banana99ou/Stewart-Platform/doc/chat_log_2026-02-09.md

# Chat log (2026-02-09) — Stewart Platform Physical HILS paper + analysis

This document summarizes the key outcomes of an assistant session focused on writing the KSAS paper, validating claims against code/logs, and updating the analysis/figure pipeline.

## Scope of the session

- Drafted example text for **Introduction / Main body / Conclusion** sections.
- Fact-checked `paper/Paper_draft.md` against:
  - implementation (`hils_host.py`, `postprocess_run.py`)
  - measured results (`logs/run-.../postprocess_metrics.json`, runs #5–#9)
- Clarified the correct interpretation of **workspace / saturation** (baseline runs are inside workspace → saturation is 0%).
- Addressed the “residual error is mainly FC mounting bias” narrative by:
  - distinguishing “simulation-vs-physical tracking” from “mounting bias”
  - implementing mounting-bias estimation using **platform pose** (commanded pose in logs) as reference
- Implemented a “one-click” figure generator and verified it runs in a venv.

## Dataset conventions agreed

- **Baseline (post-fix)**: runs **#5–#9** (firm mounting, speed PID enabled).
- **Hero run for time-series figures**: run **#8**.
  - Rationale: best-looking overlay and lowest pitch error RMS among runs #5–#9 (also recorded in `ToDo.md`).
- **Pre-fix illustrative run**: run **#4** (loose mounting; not comparable to baseline for aggregate stats).
- **Analysis window**: default skip first **10 s** to avoid startup transients.

## Key findings extracted from logs (runs #5–#9)

- **Saturation**:
  - `pct_saturated_count = 0.0%`
  - `pct_saturated_time = 0.0%`
  - Interpretation: baseline runs remain within feasible workspace; clamping/saturation is not active during the reported dataset.
- **Latency (paper-quotable ranges across runs #5–#9)**:
  - Stewart serial RTT mean ≈ 21.6–21.9 ms; P95 ≈ 33.6–33.9 ms; max up to ~80 ms (run dependent).
  - End-to-end proxy (PX4 rx → ACK rx) mean ≈ 20.4–20.7 ms; P95 ≈ 32.9–33.2 ms.
  - End-to-end proxy (X-Plane rx → ACK rx) mean ≈ 26.4–31.3 ms; P95 ≈ 48.9–62.8 ms.

## Methodology correction: mounting bias reference

An important correction was made:

- **Mounting bias** must be estimated from **PX4 attitude vs platform pose** (top plate frame).
- Using **X‑Plane attitude** as the mounting-bias reference was rejected as conceptually invalid.
- The chosen reference available in logs is the **commanded platform pose** in `tick.csv`:
  - `cmd_roll_deg`, `cmd_pitch_deg`, `cmd_yaw_deg`

## Code changes introduced

### 1) `postprocess_run.py`

Added mounting-bias estimation and bias-corrected tracking metrics:

- Reads `scenario_phase` from `tick.csv`.
- Estimates mounting bias in a steady window:
  - Prefer `scenario_phase == "hold_0"` and `pid_enabled == 1` (when present), within the analysis window.
  - Computes (roll/pitch):
    - `bias = mean(wrap(px4 - cmd))`
- Emits:
  - `mounting_bias_deg` in the output metrics JSON.
  - Additional error series in `tracking_error_deg`:
    - `roll_px4_biascorr_minus_xp_deg`, `pitch_px4_biascorr_minus_xp_deg`
    - `roll_px4_biascorr_minus_cmd_deg`, `pitch_px4_biascorr_minus_cmd_deg`
- Pitch response plot updated to include:
  - `X-Plane pitch + mounting bias` (shifted by the estimated bias) for visual alignment.

### 2) `paper/Paper_draft.md`

Updated Section 6–7 and Conclusion to match the new method:

- Explicitly states mounting bias is estimated from **PX4 − commanded platform pose** during `hold_0`.
- States that **pre/post bias-correction** tracking errors are presented.

### 3) `paper/Fig_Gen.py`

Added a new “one-click” figure generator that uses real logs (not synthetic data):

- Loads:
  - baseline runs #5–#9
  - hero run #8
  - pre-fix run #4 (for before/after illustration)
- Applies analysis window (skip first 10 s).
- Estimates pitch mounting bias from `wrap(px4_pitch - cmd_pitch)` in `hold_0`.
- Writes figures to `paper/fig/`:
  - `Fig2_PitchResponse_Hero.png`
  - `Fig3_PitchError_Hero.png` (raw vs bias-corrected)
  - `Fig4_MountingBias_TimeSeries.png` (pre vs post)
  - `Fig5a_Latency_TimeSeries_Hero.png`
  - `Fig5b_Latency_Distribution_Baseline.png`
  - `FigGen_manifest.json`

## Figure strategy agreed (for Section 7: Results & Discussion)

- **Fig2 (hero run)**: pitch response overlay (readability).
- **Fig3 (hero run)**: tracking error time series, raw vs bias-corrected.
- **Fig4**: “mounting bias proof”
  - preference: Option B time series (shows initial chaos → stable offset), with an optional aggregate inset/table.
- **Fig5**: latency/timing evidence
  - include both hero run time series and aggregate distributions across baseline runs (#5–#9).
- Use run #1–#4 only as “pre-fix” illustration, not in baseline aggregates.

## Environment notes

- A Python virtual environment was created at `.venv/` and `pip install -r requirements.txt` was used to install:
  - numpy, matplotlib, pyserial, pymavlink
- `paper/Fig_Gen.py` was executed successfully in the venv and generated the listed PNG outputs under `paper/fig/`.
