banana99ou/Stewart-Platform/presentation/Conference_presentation_script.md

# Conference Presentation Script

Korean spoken script first (for reading aloud), English reference below (for LLM context).
Slide numbers match the current deck (17 slides).

---

# 발표 대본 (Korean Spoken Script)

## 슬라이드 1 — 제목

안녕하세요, 국민대학교 미래모빌리티제어연구실 석사과정 정현용입니다.

오늘은 비행 시뮬레이션에 맞춰 실제 비행 하드웨어가 반응하는 걸 눈으로 확인할 수 있는 시스템을 소개하겠습니다. 플랫폼이 기울면 조종면이 실제로 움직이도록, 스튜어트 플랫폼 위에 실물 UAV를 탑재하고, X-Plane 시뮬레이터와 하나의 루프로 연결했습니다. 

시스템 구조, baseline 실험 결과, 그리고 정량적으로 확인한 가능성과 한계를 보여드리겠습니다.

`>> NEXT SLIDE`

## 슬라이드 2 — 왜 물리적 운동을 HILS에 추가하는가?

그러면 왜 HILS에 실제 움직임을 추가해야 할까요?

핵심은 가상 입력을 넣는 데서 끝내지 않는다는 점입니다. 비행 제어기와 IMU가 실제 운동을 경험하고, 그 결과가 조종면 반응으로 이어지는지를 직접 확인하고자 했습니다.

저희는 이를 고정익으로 먼저 실증했고, 원리적으로는 다른 기체에도 적용 가능합니다.

오늘은 이 시스템이 안정적으로 동작하고, 추종 성능을 정량화할 수 있다는 것을 실험 데이터로 보여드리겠습니다.

`>> NEXT SLIDE`

## 슬라이드 3 — 무엇이 새로운가?

그러면 구체적으로 뭐가 새로운 걸까요?

첫째, 비행 하드웨어가 시뮬레이션 시나리오에 맞춰 실제로 반응하는지를 눈으로 확인할 수 있습니다. 기존 HILS에서는 로그나 화면으로만 확인하던 것을, 여기서는 물리적으로 직접 볼 수 있습니다.

둘째, PX4의 추정기가 합성 신호가 아니라 실제 관성 운동에 반응합니다. 소프트웨어로 주입된 데이터가 아니라 진짜 움직임을 추정기가 경험하는 겁니다.

스튜어트 플랫폼이 이 두 가지를 가능하게 하는 물리적 연결 고리입니다. 실제 데이터로 보여드리겠습니다. 먼저 시스템이 작동하는 모습부터 보겠습니다.

`>> NEXT SLIDE`

## 슬라이드 4 — 시스템 구동 모습

[데모 영상 재생]

지금 보시는 것은 baseline 실험인 트림 전환 시나리오입니다. X-Plane이 피치 0도에서 +5도로 전환하면, 스튜어트 플랫폼이 그에 맞춰 기울어집니다. 조종면이 실제로 움직이는 게 보이실 겁니다 — 비행 제어기가 시뮬레이션에 맞춰 물리적으로 반응하고 있는 것입니다.

다음으로 시스템 구조를 살펴보겠습니다.

`>> NEXT SLIDE`

## 슬라이드 5 — 물리적 폐루프 동작 원리

이제 폐루프가 실제로 어떻게 동작하는지 보겠습니다.

[그림 1: 시스템 구조/데이터 흐름도 — 번호 1~4 표시]

그림에 표시된 대로, X-Plane 상태가 호스트를 거쳐 플랫폼 명령이 되고, PX4가 그 움직임을 감지해서 다시 호스트로 돌아옵니다. 호스트의 PID가 조종면 명령을 X-Plane에 주입하면 루프가 닫힙니다. 각 블록을 자세히 보겠습니다.

`>> NEXT SLIDE`

## 슬라이드 6 — 블록 1: X-Plane 시뮬레이터

[구조도에서 1번 블록 강조]

X-Plane이 동역학을 연산하고, UDP로 기체 상태를 호스트에 전송합니다. 기존에는 이 안에서 루프가 닫혔지만, 이 구조에서는 PX4 자세가 물리적 경로를 거쳐 되돌아옵니다. 즉 시뮬레이터는 동역학 연산에 집중하고, 센서 반응은 실제 하드웨어가 담당하는 구조입니다.

`>> NEXT SLIDE`

## 슬라이드 7 — 블록 2: Python 호스트

[구조도에서 2번 블록 강조]

호스트는 통합 허브입니다. X-Plane 상태와 PX4 추정값을 동시에 수신하고, 플랫폼 명령 변환, 공통 타임스탬프 로깅, PID 제어 출력까지 모두 여기서 처리합니다. 각 스트림이 서로 다른 주기로 들어오기 때문에, 여기서의 타이밍 처리가 전체 루프 지연에 직접 영향을 줍니다.

`>> NEXT SLIDE`

## 슬라이드 8 — 블록 3: Stewart 플랫폼 구동

[구조도에서 3번 블록 강조]

스튜어트 플랫폼은 호스트의 pose 명령을 받아 실제 물리적 모션으로 변환합니다. 시리얼 명령-ACK 왕복 시간은 약 22 ms입니다. 이 블록 이후부터 PX4가 경험하는 것은 실제 관성 운동입니다. 이 물리적 변환이 기존 소프트웨어 HILS와 구분되는 핵심 지점입니다.

`>> NEXT SLIDE`

## 슬라이드 9 — 블록 4: PX4 센싱 및 귀환

[구조도에서 4번 블록 강조]

PX4의 IMU가 플랫폼의 실제 운동을 감지하고, 추정기가 자세를 산출합니다. 이 추정값이 호스트로 돌아와 PID 제어기를 거쳐 X-Plane에 주입되면 루프가 완성됩니다. 중요한 건, PX4 펌웨어를 별도로 수정하지 않았다는 점입니다. PX4 입장에서는 그냥 실제 운동을 감지하고 반응할 뿐입니다.

`>> NEXT SLIDE`

## 슬라이드 10 — 실험 설계 및 측정 방법

자, 그러면 실제로 무엇을 실험했는지 보겠습니다.

기본 시나리오는 trim transition입니다. 피치를 0도에서 +5도로 올렸다가, 유지한 뒤, 다시 돌아옵니다. 모든 실험은 동일한 X-Plane 초기 조건인 호놀룰루 PHNL 10해리 어프로치에서 시작합니다.

각 실험은 포화 플래그를 감시하면서 9회 반복하여 통계적 유의미성을 확보했습니다. 시스템 자체의 지연, 바이어스, 장착 효과를 먼저 분리해야 하므로, 이처럼 제어된 조건의 깨끗한 baseline 시나리오에서 출발합니다.

`>> NEXT SLIDE`

## 슬라이드 11 — 결과 1: 폐루프 추종 달성

이제 결과를 보겠습니다.

[그림 2: 피치 응답 오버레이]

주황색 선이 PX4 피치, 파란 점선이 X-Plane 명령 피치입니다. 전체적으로 안정적으로 추종하고 있는데, 약 1.8도 정도 일정하게 벌어져 있는 걸 볼 수 있습니다. 이건 장착 바이어스로 추정됩니다. 이 바이어스만큼 보정한 것이 파란 실선인데, 보정 후에는 추종이 훨씬 가까워집니다.

핵심은, 폐루프 추종이 작동하고, 지배적 오차가 물리적으로 설명된다는 점입니다.

`>> NEXT SLIDE`

## 슬라이드 12 — 결과 2: 장착 품질이 주된 오차의 원인

바이어스가 있다면, 어디서 오는 걸까요? 장착 품질이 원인이라는 가설을 두 가지 근거로 확인했습니다.

[그림 3: 피치 오차 + 그림 4: 장착 바이어스 근거]

첫 번째 근거. 장착 조건을 바꾸면 바이어스의 거동이 달라집니다. 느슨한 장착 — 접착 테이프만 사용한 조건에서는 관성 하중에 의해 FC가 서서히 밀리면서 바이어스가 시간에 따라 증가합니다. 단단한 장착 — 접착제에 기계적 결속을 추가한 조건으로 바꾸면 이 드리프트가 사라집니다.

두 번째 근거. 단단한 장착 조건에서 남는 바이어스는 실험 내내 거의 일정합니다. 이는 남은 오차가 동적 불안정이 아니라, 장착 시 생긴 고정된 정렬 오차라는 뜻입니다.

두 근거를 종합하면, 주된 피치 오차의 원인은 제어 시스템이 아니라 장착 품질입니다. 장착을 잡으면 오차가 보정 가능한 정적 바이어스로 수렴하며, 후처리 스크립트가 이 바이어스를 자동으로 추정하고 보정합니다.

`>> NEXT SLIDE`

## 슬라이드 13 — 결과 3: 지연 특성화 및 시스템 성능

추종이 되는 것은 확인했는데, 그러면 이 시스템이 얼마나 빠르게 반응할 수 있을까요?

[그림 5(a): 지연 시계열 + 그림 5(b): 지연 분포]

지연을 네 구간으로 분해했습니다. X-Plane 샘플 에이지는 시뮬레이터 데이터가 호스트에서 사용될 때까지의 경과 시간, PX4 샘플 에이지는 PX4 자세 추정값이 호스트에 도달할 때까지의 경과 시간, 시리얼 RTT는 호스트에서 플랫폼으로 명령을 보내고 ACK를 받기까지의 왕복 시간, 종단간 지연은 X-Plane 데이터 수신부터 플랫폼 구동 완료까지의 총 시간입니다.

왼쪽 시계열에서 각각 파란색, 주황색, 초록색, 빨간색으로 표시했고, 실선이 구간 평균, 음영이 최소-최대 범위입니다. 빨간 종단간 선이 약 40에서 60 ms 대에서 움직입니다.

오른쪽 박스 플롯은 baseline 5회 전체의 분포입니다. 종단간 중앙값이 약 48 ms이고, X-Plane 에이지 약 27 ms, PX4 에이지 약 19 ms, 시리얼 RTT 약 22 ms가 겹쳐 누적됩니다.

실용적으로 보면, 이 정도 지연은 오늘 보신 트림 전환처럼 천천히 변하는 기동에는 충분하지만, 급격한 교란을 재현하려면 제약이 될 수 있습니다.

이렇게 누적된 지연이 시스템이 얼마나 빠른 움직임까지 재현할 수 있는지를 결정합니다. 분포에서 보시듯 지터 폭이 상당하기 때문에, 현재 데이터만으로 유효 bandwidth를 확정하기는 어렵습니다. 이 부분은 향후 sine-sweep 측정으로 정량화할 계획입니다.

`>> NEXT SLIDE`

## 슬라이드 14 — 핵심 정리

정리하겠습니다.

첫째, 시뮬레이션 시나리오에 맞춰 실제 비행 하드웨어가 물리적으로 반응하는 것을 확인할 수 있는 시험 환경을 구현했습니다. X-Plane, 스튜어트 플랫폼, PX4가 하나의 물리적 폐루프로 동작합니다.

둘째, 이 시스템의 추종 성능을 정량적으로 확인했습니다. 바이어스 보정 후 피치 추종 오차 RMSE 약 0.46도, 종단간 지연 약 48 ms입니다.

셋째, 시스템 특성화를 통해 향후 확장의 기반을 확보했습니다. 지연, 바이어스, 작업 영역의 한계를 정량적으로 파악함으로써, 교란 실험이나 다른 기체로의 확장을 위한 baseline을 마련했습니다.

다만 이 시스템이 기존 소프트웨어 HILS나 실제 비행 시험을 대체하는 것은 아닙니다. 플랫폼의 작동 영역은 유한하고, 공기역학적 하중은 재현하지 못하며, 유효 bandwidth도 아직 측정이 필요합니다. 이 시스템의 위치는 소프트웨어 HILS와 비행 시험 사이의 보완적 검증 수단입니다.

향후 계획으로는, 단기적으로 시간 정렬 오차 분석, sine-sweep 기반 bandwidth 측정, 반복성 특성화, 포화 경계 부근 스트레스 시험을 예정하고 있습니다. 장기적으로는 멀티로터 등 다른 기체로 확장하여 아키텍처의 범용성을 실증하는 것이 목표입니다.

`>> NEXT SLIDE`

## 슬라이드 15 — 마무리

감사합니다.

`>> BACKUP SLIDE (if needed)`

## Q&A 답변

가능성 높은 순서로 정렬했습니다. 각 답변에 프레젠테이션 이동 지시를 포함했습니다.

**1. "공기역학적 하중을 재현하지 못하는데, 그러면 실제 비행과 얼마나 비슷한가?"**
[프레젠테이션: 슬라이드 14로 이동 — 한계와 위치 설명]
실제 비행과 완전히 같다고 말할 수는 없습니다. 다만 비행 시나리오와 기체 동역학은 X-Plane이 제공하고, 그 결과에 맞춰 실제 하드웨어가 물리적으로 움직이면서 PX4의 IMU와 추정기가 합성 신호가 아니라 실제 운동을 경험합니다. 따라서 순수 software HILS보다는 실제 비행에 가깝지만, flight test를 대체하지는 않는 보완적 수단이라고 설명하는 것이 정확합니다.

**2. "왜 기존 software HILS가 아니라 이 시스템이 필요한가? 시험평가 관점에서 어떤 추가 가치가 있나?"**
[프레젠테이션: 슬라이드 3으로 이동 — 핵심 차별점 슬라이드]
핵심은 센서 신호를 소프트웨어로 합성해 넣는 데서 끝나지 않는다는 점입니다. 이 시스템에서는 비행 제어기와 IMU가 실제 물리 운동을 경험하고, 그 결과가 다시 폐루프에 반영됩니다. 즉 software HILS보다 물리성이 높고, 제어기와 추정기가 실제 운동에 어떻게 반응하는지를 직접 관찰할 수 있다는 점에서 시험평가 단계의 추가 정보를 제공합니다.

**3. "지연은 어떻게 측정했고, 이 지연으로 볼 때 어느 정도 기동까지 평가 가능한가?"**
[프레젠테이션: 슬라이드 13으로 이동 — 지연 데이터 보여주며 답변]
호스트 기준의 공통 타임스탬프로 각 스트림의 수신 시각과 Stewart ACK 시각을 기록하고, 이를 tick 시각 축에 인과적으로 다시 맞춰 X-Plane sample age, PX4 sample age, serial RTT, end-to-end delay를 계산했습니다. 현재 근거로 제시할 수 있는 것은 종단간 지연 약 48 ms와 그 분포이며, 지터 폭이 있기 때문에 현재 데이터만으로 유효 attitude bandwidth를 확정하는 것은 과도한 주장입니다. 그래서 지금 단계에서는 trim transition 같은 저주파 기동에 적합하다고 설명하고, 정량적 bandwidth는 전용 sine-sweep 측정으로 제시할 계획입니다.

**4. "실험 간 반복성은 어떤가? 다시 장착하거나 다시 실행해도 같은 결과가 나오나?"**
[프레젠테이션: 슬라이드 12로 이동 — Fig 4 보여주며 답변]
firmly fixed baseline 5회 기준으로 보면, 실험 내 바이어스 표준편차는 약 0.2°이고 실험 간에는 최대 0.8° 정도 차이가 나타났습니다. 이는 열적 드리프트와 미세한 재장착 차이 때문으로 보고 있습니다. 즉 완전히 무시 가능한 수준이라고 하기는 어렵지만, 반복 실험을 통해 변동 폭을 확인했고 체계적인 반복성 특성화는 향후 과제로 남아 있습니다.

**5. "아까는 9회 반복이라고 했는데, 뒤에서는 baseline 5회라고 했다. 정확히 어떤 데이터셋으로 평가한 건가?"**
[프레젠테이션: 슬라이드 10으로 이동 — 실험 집합 설명]
총 9회가 맞습니다. 이 중 4회는 loose mounting 조건이고, 5회는 firmly fixed mounting 조건입니다. 발표 후반의 baseline 분포와 정량 평가는 firmly fixed된 5회 run을 중심으로 해석했고, loose mounting 4회는 장착 품질이 바이어스 거동에 어떤 영향을 주는지 비교하기 위한 근거로 사용했습니다.

**6. "플랫폼이 개루프인데 포즈 정확도를 얼마나 신뢰할 수 있나?"**
[프레젠테이션: 슬라이드 15 유지 — 구두 답변]
저비용 구현을 위해 인코더 피드백이 없는 RC 서보를 사용했기 때문에 플랫폼 자체는 개루프 구동입니다. 그럼에도 디지털 경사계로 정적 자세 정확도를 측정한 결과, 롤 약 0.1도, 피치 약 0.5도 수준의 오차 상한을 확인했습니다. 즉 플랫폼 포즈를 연속적으로 직접 피드백하지는 않지만, 플랫폼 수준 오차가 어느 정도인지는 별도로 확인했고, 루프 안에서는 PX4 IMU가 유일한 물리 측정 수단으로 동작합니다.

**7. "장착 바이어스가 주된 오차라면, 이 결과는 시스템 성능보다 장착 품질을 본 것 아닌가?"**
[프레젠테이션: 슬라이드 12로 이동 — Fig 3/4 보여주며 답변]
오히려 이번 결과의 중요한 결론이 바로 그 점입니다. 주된 피치 오차가 제어기 불안정이나 루프 붕괴가 아니라, 장착 품질에서 비롯된 물리적 정렬 오차로 설명된다는 것을 확인했습니다. 즉 폐루프 자체는 동작하고 있고, 지배적 오차원이 무엇인지 분리해냈다는 점이 의미입니다. 장착이 안정화되면 오차는 보정 가능한 정적 바이어스로 수렴합니다.

**8. "왜 pitch trim transition만 먼저 검증했나? 시험 시나리오가 너무 단순한 것 아닌가?"**
[프레젠테이션: 슬라이드 10으로 이동 — 실험 설계, 필요하면 슬라이드 14로 이동]
첫 단계에서는 시스템 자체의 지연, 바이어스, 장착 효과를 먼저 분리해서 보기 위해 가장 해석이 깔끔한 baseline 시나리오를 선택했습니다. 그래서 pitch 중심 trim transition으로 시작했습니다. 단순 시나리오를 먼저 택한 이유는 시스템 특성화를 명확하게 하기 위해서이며, 다축 기동과 스트레스 시험은 다음 단계 과제로 두었습니다.

**9. "포화는 어떻게 관리했고, 결과가 포화 영향 없이 나온 것이라고 볼 수 있나?"**
[프레젠테이션: 슬라이드 10으로 이동 — 실험 설정 슬라이드]
baseline 명령이 z=+20 mm에서의 가용 회전 범위 안에 들어오는지 먼저 확인하고, Stewart saturation flag를 계속 모니터링했습니다. baseline 지표에서는 run에 따라 포화 비율이 0-1% 수준이어서, 현재 발표의 baseline 결과는 대체로 정상 영역 거동으로 해석하고 있습니다. 포화 경계 부근의 동작은 별도의 stress test로 다루는 것이 더 적절합니다.

**10. "이 시스템은 결국 무엇을 검증하는 도구인가? 비행제어기 성능인가, 센서 반응인가, 아니면 통합 시험환경 자체인가?"**
[프레젠테이션: 슬라이드 14로 이동 — 핵심 정리 슬라이드]
현재 단계에서는 통합된 물리적 폐루프 시험 환경을 구현하고, 그 기본 특성을 정량화했다고 표현하는 것이 가장 정확합니다. 즉 완성된 비행제어 성능 검증 체계를 최종 확립했다기보다, 비행 하드웨어 반응, 추종 성능, 지연, 바이어스, 작업 영역의 한계를 함께 평가할 수 있는 baseline 시험 플랫폼을 제시한 것입니다.

---

## 발표 운용 참고사항

- 기술적 심화는 슬라이드 11(추종), 12(바이어스), 13(지연)에 집중.
- 슬라이드 4 (데모 영상)에서 트림 전환 시나리오를 구두로 연결 — 15~20초 이내, "이 동작의 데이터를 결과에서 보겠습니다"로 전환.

---
