banana99ou/Stewart-Platform/doc/Prof_feedback_2026-03-20_presentation.md

# Professor Feedback — KSAS Presentation Draft (2026-03-20)

Context: 1차 초안 (압축_발표_대본.pdf + KSAS_Spring2026_Presentation.pdf) 기반 피드백

---

## Original questions asked

1. 연구 framing: broader physical HILS vs IMU-in-the-loop estimator validation 중심
2. Stewart platform 설명 범위: working area/z 선정/saturator 등 어디까지 포함할지

## Feedback

1. 둘 다 좋아 보이는데 정현용학생이 학회에서 참가자분들과 논의하기 편리한 것으로 하시면 됩니다.
2. 학회 발표시에는 세부적인 디테일은 그냥 표 정도로 넣고 참고용으로 제시만 하시고 시시콜콜 설명하지 않는 편이 낫겠습니다. 프로젝트의 스토리텔링에 집중해서 청중들이 흥미로워할 수 있는 부분을 강조해 주세요.
3. 초안에서 사진이 아직 없어서 아쉬운데 작동 동영상도 있으면 좋겠습니다. 단순히 작동하는거 봤지? 가 아니라 특정 시나리오에 대한 작동 영상을 보여주면서 움직님을 설명할 수 있는 것으로요.
4. 폰트가 너무 얇아서 잘 안보일것같습니다. 발표 환경에 강건하게 잘 보이는 폰트로 하시고 큼직큼직하게 해주세요. 굳이 안 읽어도 전체 흐름 이해에 문제없는 내용만 작은 글씨로 하세요.
5. 5페이지 블록 요소별로 대표 사진 + 다른 요소와 주고받는 정보에 대한 상세설명 슬라이드를 만들어 주세요. 깔끔하게 하시긴 했는데, 처음 보는 입장에서 한 슬라이드에 들어가는 정보가 너무 많으므로 분산시키면 좋겠습니다.
6. 각 그래프들 배치는 널찍널찍하게 잘 하셨습니다만, 실선 굵기를 좀 더 굵게 해서 잘 보이게 하시고 겹치는 부분이 많은 그래프는 마커나 점선 등으로 확실히 구분되게 해주세요.
7. 표지에 국문 제목도 적어주세요.
