banana99ou/Stewart-Platform/paper/fig/Decision Options A B Flow-2026-02-05-113706.png

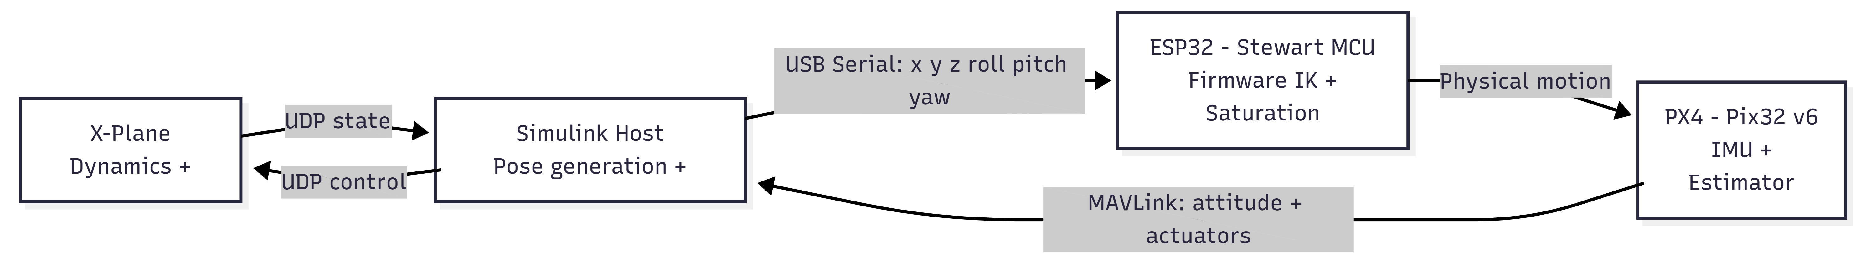
paper/fig/Decision Options A B Flow-2026-02-05-113706.png
