banana99ou/Stewart-Platform/paper/fig/Fig2_TrimTransition.png

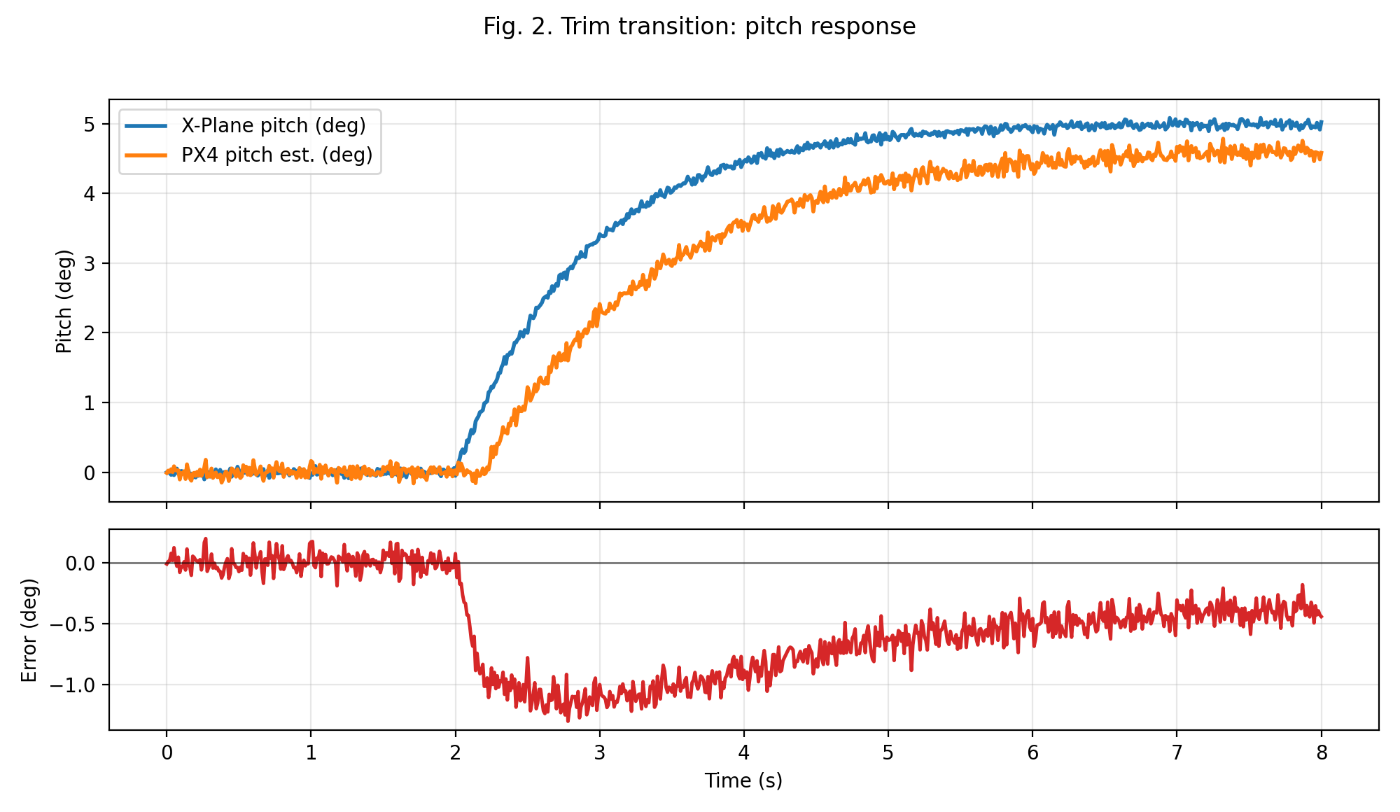
paper/fig/Fig2_TrimTransition.png
