banana99ou/Stewart-Platform/paper/fig/Fig3_LatencyBreakdown.png

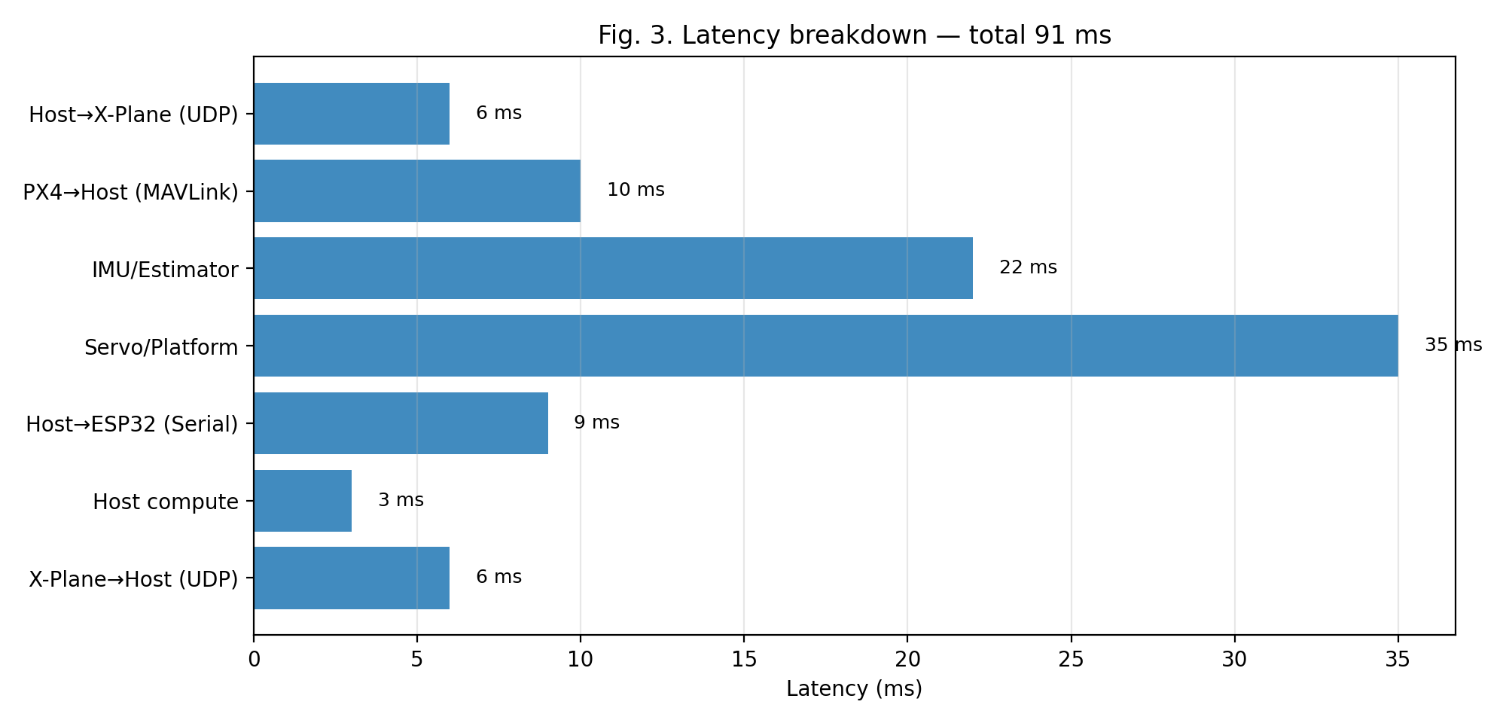
paper/fig/Fig3_LatencyBreakdown.png
