banana99ou/Stewart-Platform/presentation/fig/Fig5a_Latency_TimeSeries.png

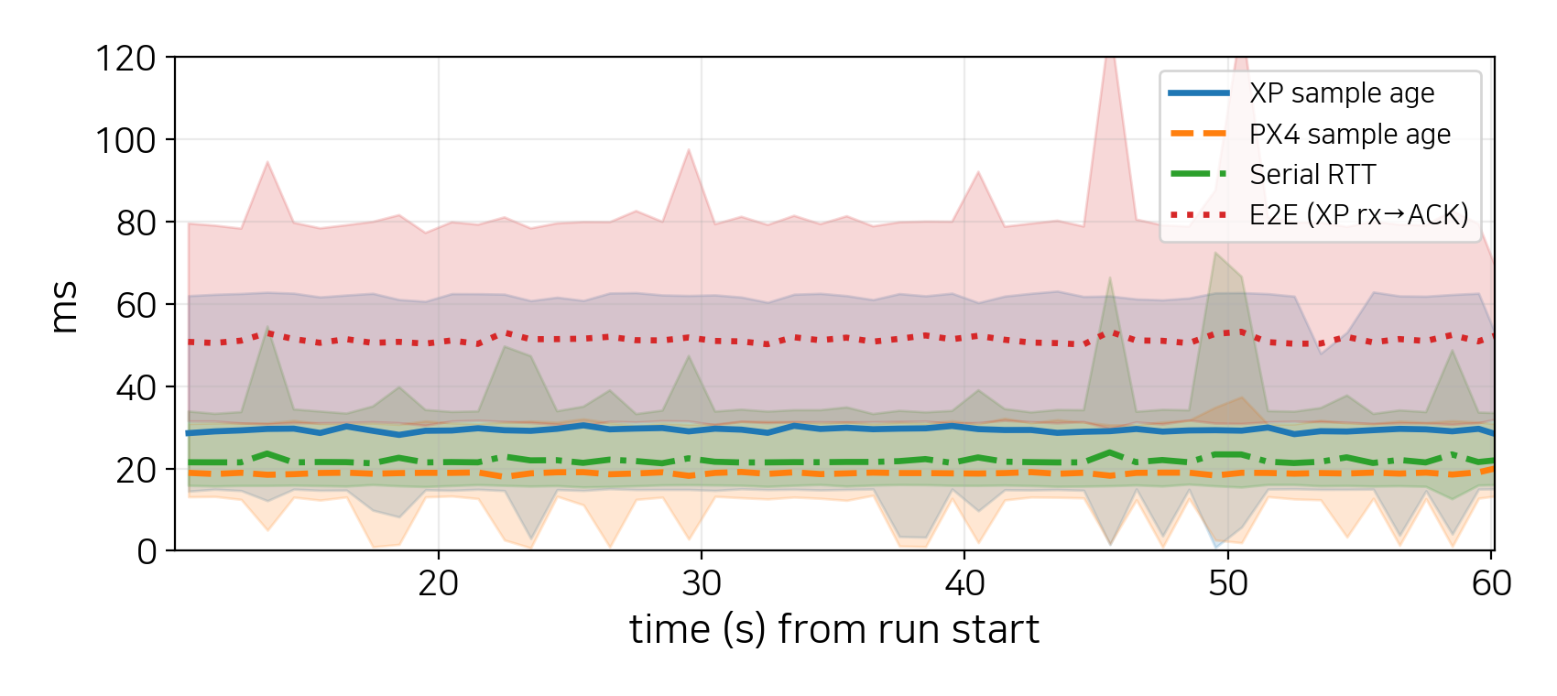
presentation/fig/Fig5a_Latency_TimeSeries.png
