banana99ou/Stewart-Platform/presentation/fig/KakaoTalk_Photo_2026-03-24-22-50-34 004.jpeg

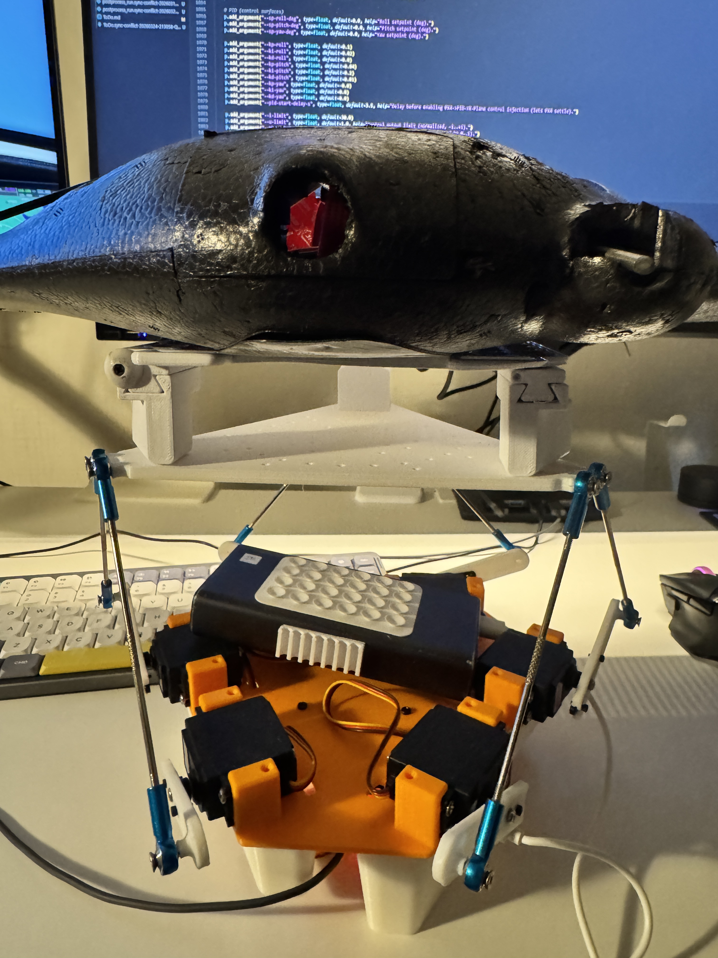
presentation/fig/KakaoTalk_Photo_2026-03-24-22-50-34 004.jpeg
