banana99ou/Stewart-Platform/presentation/fig/PX4_on_STP.JPG

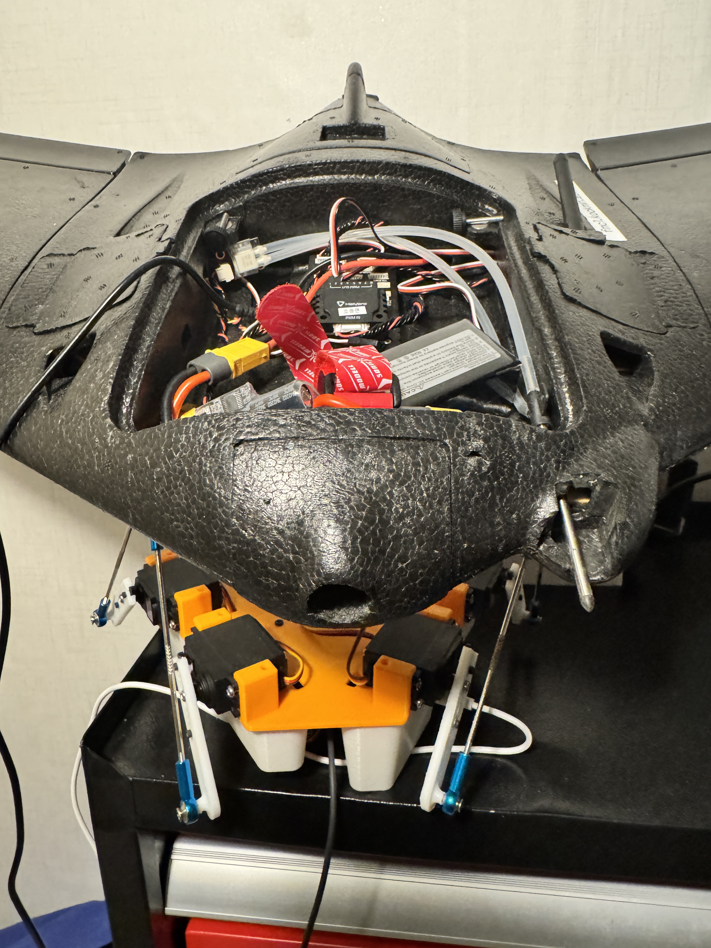
presentation/fig/PX4_on_STP.JPG
