banana99ou/Stewart-Platform/rot_boundary_slices.png

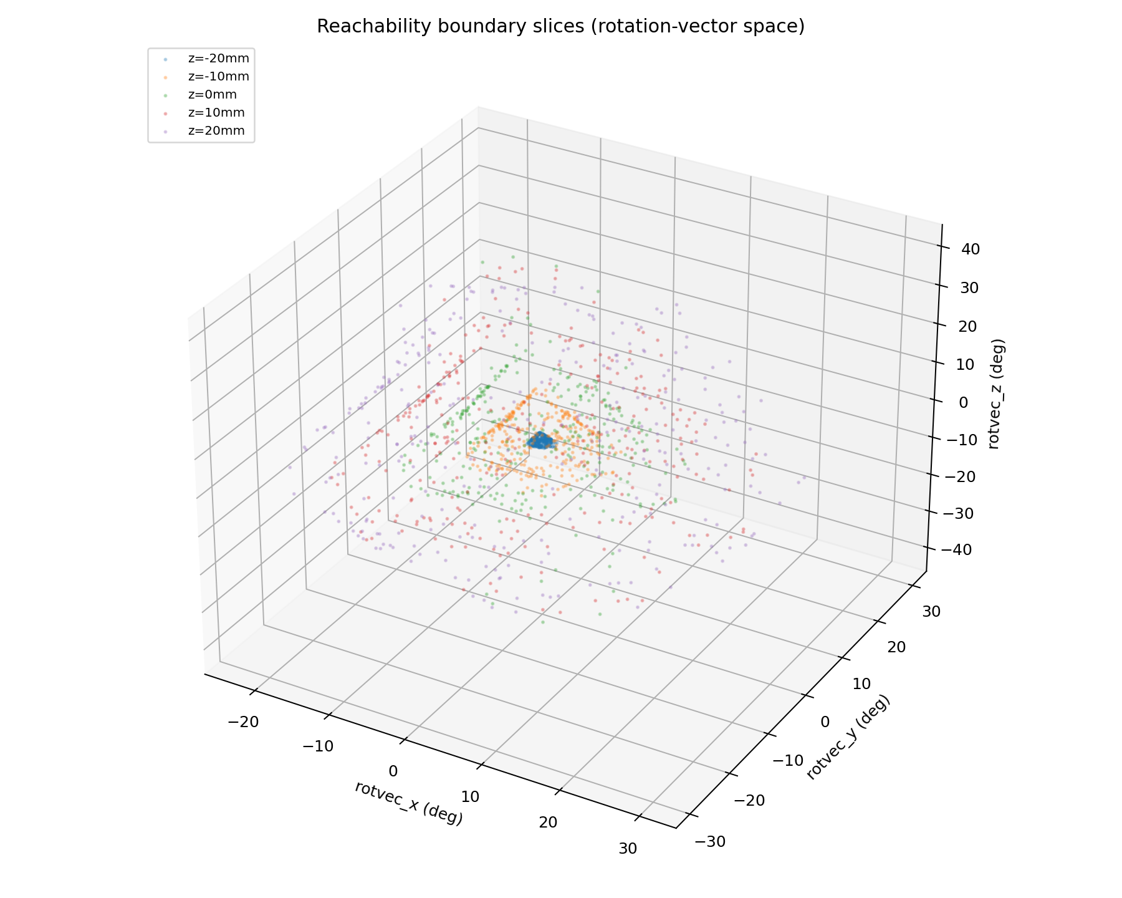
rot_boundary_slices.png
