banana99ou/Stewart-Platform/presentation/fig/Assembly.png

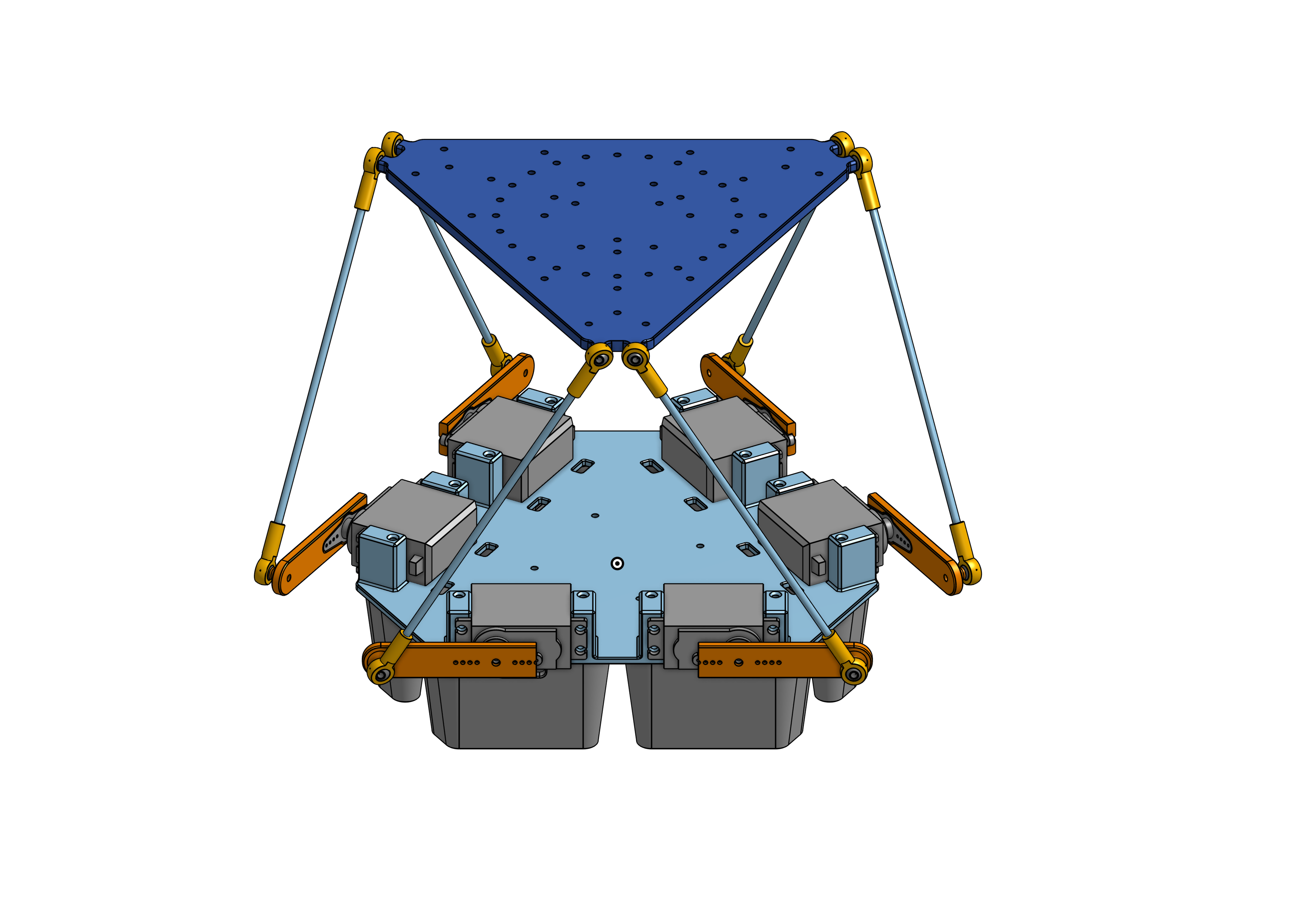
presentation/fig/Assembly.png
