banana99ou/Stewart-Platform/(commit log)

2025-07-19 confirmed working with pin D13.
2025-08-06 migrate to ESP32
2025-08-09 Implement inverse kinematics for 6-DOF Stewart platform with servo control
2025-12-27 Add inverse kinematics functions and improve plotting for Stewart platform
2025-12-27 actuation range derived. servo rotation axis fixed
    [coordinate_generator.py]
2025-12-27 Refactor main.ino for minimal ESP32 servo test; removed inverse kinematics, added serial command handling for servo control.
2025-12-27 Implement full inverse kinematics for Stewart platform with enhanced serial command handling and leg control for ESP32. Updated configuration, geometry, and runtime state management for improved perf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
2025-12-28 translate to arduino code
2026-01-26 read from IMU, feed to simulink
2026-01-30 rotate fix web ui. turn on verbose print.
    [main.ino]
2026-01-30 - read attitude from FC - implement PID controller - UDP to simulink
2026-02-02 add comments add ik debug prints
2026-02-05 add status flag. add status flag broadcast via serial and UDP. fix servo pwm us range.
    [main.ino]
2026-02-05 make actuation range probing code
    [rot_rotmag_lut.csv]
2026-02-07 make central python code. Fix stewart cmd sender Fix Xplane receiver Confirm PX4 working.
    [hils_host.py]
2026-02-07 working Xp TX. reset platform pose at exit
    [hils_host.py]
2026-02-07 ESP32: minimal ACK to reduce serial RTT
    - Add short per-command ACK: seq/rx_us/done_us/sat/ik\n- Disable verbose ACK when minimal ACK is enabled\n- Increase Serial baud to 500000 for higher telemetry headroom
    [main.ino]
2026-02-07 hils_host: yaw bias alignment + startup ramp/PID delay; X-Plane DATA0 parity
2026-02-07 Add detailed documentation for calibrating and validating the Stewart Platform's accuracy, covering PWM endpoint calibration, servo bias, and measurement techniques.
2026-02-08 add Speed PID autocall postprocessing.
2026-02-08 Test for Rotation order related tracking error checker.
    [tracking_error_tester.py]
2026-02-08 # postprocess: add saturation stats, analysis window, and improved plots - Compute saturation metrics from ACKs (alpha/sat) and condition error stats on saturation - Add CLI options to skip startup t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
    [postprocess_run.py]
2026-02-10 paper draft near finish
    [mounting_bias_pitch_baseline.csv]
2026-02-12 # account for mounting bias - calc bias in mounting at hold_0 epoc avg - subtract bias from tracking error - show corrected pitch response plot
    [postprocess_run.py]
2026-02-12 Add standalone script for computing all-axis error metrics for runs #5–#9
2026-03-12 fix latency analysis to use causal sample matching
    Recompute X-Plane and PX4 sample-age and rx-to-ACK metrics using the latest
    sample at or before each control tick, instead of the row-wise tick snapshot.
    This removes impossible negative latency values and makes the reported timing
    metrics causally consistent with the logged streams.
    [postprocess_run.py]
2026-03-17 add KSAS Spring 2026 conference presentation
    Consolidate all presentation assets into presentation/ folder:
    - generate_presentation.py: bilingual (EN primary, KR grey) slide generator
    - Conference_presentation_script.md: bilingual speaking script with Q&A
    - 춘계 항공우주학회 논문 발표 준비 계획서.md: planning document
    - fig/: all figures used in the presentation
    - KSAS_Spring2026_Presentation.pptx: generated 12-slide deck
    Made-with: Cursor
2026-03-19 presentation Fig_Gen: improve figure readability for slides
    - Fig2: swap line styles (raw X-Plane dotted, fixed solid)
    - Fig3: shorten legend labels to avoid line breaks
    - Fig4: rename subplots to "Loose/Firm mounting", fold mean
    bias into trace label, remove separate mean legend entry
    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
2026-03-19 script: improve Korean translations and add vehicle-generality messaging
    Rewrote all Korean translations for natural spoken register
    (sentence structure, word choice, connectors). Added vehicle-agnostic
    expansion points in Slides 2, 3, and 11 to avoid underselling the
    testbed's breadth. Includes inline #! review notes for next revision.
    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
2026-03-19 script: address review critiques and rewrite for spoken delivery
    - Slide 8: rewrite to explain mounting bias via loose vs firm comparison
    - Slide 9: define timing terms before analysis, add system perf summary
    - Remove dedicated limitations slide, fold into Slide 3 briefly
    - Add closing slide (Slide 11), renumber to maintain 12-slide deck
    - Q&A: fix saturation answer, add servo cost/inclinometer context
    - Full spoken-register pass: shorter sentences, conversational transitions,
    bridge questions between slides, natural Korean throughout
    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
2026-03-20 presentation: spoken-delivery rewrite, add experiment details, apply author name
    Script: full spoken-register rewrite (conversational transitions, shorter
    sentences, bridge openings for slides 8/9). Added X-Plane scenario
    (PHNL 10nm), grace period, SAT monitoring, 9 reps/condition, +1.8 deg
    bias value, pose command logging. Professionalized mounting description.
    Replaced 원시→보정 전. Removed dedicated limitations slide; folded into
    slide 3 and takeaways. Added closing slide. Author: 정현용, 국민대학교.
    Generator: applied author name/affiliation to title slide.
    Fig_Gen + figures: updated for presentation.
    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
2026-03-20 script: restructure Korean-first layout, apply author name, fix translation issues
    Reorganized script with Korean spoken section on top for reading aloud,
    English reference section below for LLM context. Applied author name
    (정현용, 국민대학교 미래모빌리티제어연구실). Fixed 원시→보정 전,
    smoothed abrupt transitions, professionalized mounting description.
    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
2026-03-24 Enhance Fig_Gen.py to include end-to-end latency visualization and adjust figure layouts
    - Added end-to-end (XP rx→ACK) latency data to the time series and boxplot figures.
    - Updated axis limits and legend positioning for improved clarity and aesthetics.
    - Adjusted y-axis limits for better representation of latency distributions.
    - Saved updated figures reflecting these changes.
2026-03-24 Update Conference Presentation Script: Adjust slide count, enhance clarity, and refine content
    - Updated slide numbers to reflect the current deck of 17 slides.
    - Improved clarity in several sections, including the explanation of the physical loop system and the role of the Stewart platform.
    - Enhanced descriptions of experimental design and results, emphasizing the impact of mounting quality on bias and performance.
    - Reorganized content for better flow and readability, ensuring a cohesive narrative throughout the presentation.
2026-03-24 Implement PX4 flight mode management and GCS heartbeat functionality
    - Added methods to set PX4 flight modes by name and send GCS heartbeats for initialization.
    - Introduced constants for PX4 flight modes and a mapping for mode names.
    - Enhanced command acknowledgment handling for setting modes and sending commands.
    - Improved heartbeat reading and printing for better diagnostics and state confirmation.
    - Refactored force-arm logic to include GCS heartbeat management during the arming process.
2026-03-24 Update ToDo.md: Mark completed tasks and add new presentation revisions
    - Checked off completed tasks related to PX4 mounting bias, post-processing edits, and saturation impact analysis.
    - Added new priorities for presentation revisions based on PI feedback, including framing direction, storytelling focus, and graph legibility improvements.
    - Updated figures and documentation requirements for the upcoming conference presentation.
2026-03-24 Update .gitignore: Add logs directory and exclude temporary PowerPoint files
    - Included 'logs/' directory to be ignored in version control.
    - Added exclusion for temporary PowerPoint files matching '~$*.pptx' to prevent clutter in the repository.
2026-03-24 Add latency statistics computation script: calc_latency_stats_logs5_9.py
    - Introduced a new script to compute and print latency statistics from baseline run directories.
    - Implemented functions to safely calculate mean, median, and count of latency values.
    - Integrated loading of run data and handling of various latency metrics, including serial RTT and end-to-end latency.
    - Ensured output is formatted as JSON for easy readability and further analysis.
2026-03-27 final powerpoint with correct title and end slide
    print to pdf
2026-04-02 Revise conference presentation script to enhance clarity and flow. Updated descriptions of the physical hardware interaction in HILS, refined terminology, and improved overall structure for better au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
2026-04-02 Update presentation file for KSAS Spring 2026 with final revisions and enhancements.
